derglow/NixieClock/README.md

# NixieClock
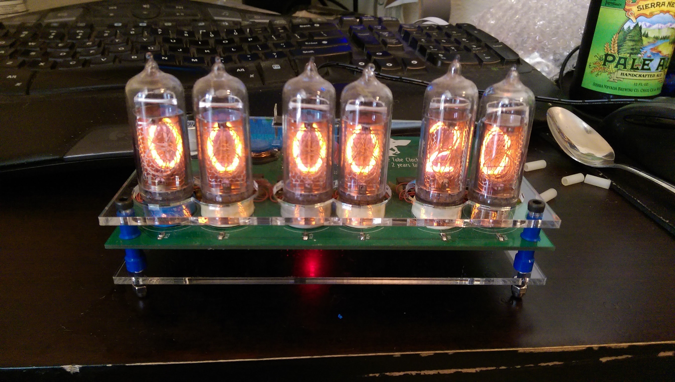
[picture p1: NixieFrontView.jpg]

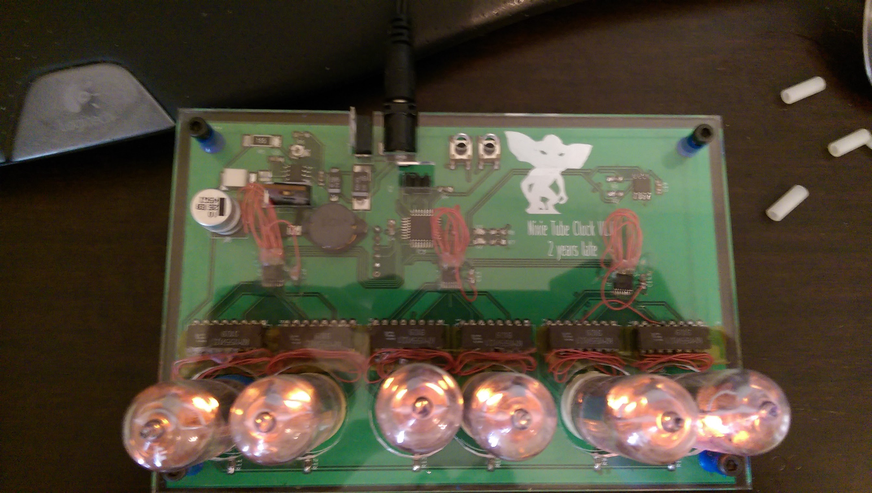
[picture p2: NixieTopView.jpg]

This repository contains the files used to make my nixie clock design. I designed the PCBs, the laser cut acrylic, and wrote the code.
