derglow/NixieClock/KiCADFinalBoard/BOM.xlsx

Sheet: FullBoardBOM
value | ref | value5 | footprint | lib | part | DigiKey PN | Column1
 | C1 | 10uF,25V | Capacitors_Tantalum_SMD:TantalC_SizeC_EIA-6032_HandSoldering | device | CP | 718-1098-1-ND
 | C10 | 100nF | Capacitors_SMD:C_0805_HandSoldering | device | C | 1276-1007-1-ND
 | C11 | 100nF | Capacitors_SMD:C_0805_HandSoldering | device | C | 1276-1007-1-ND
 | C12 | 100nF | Capacitors_SMD:C_0805_HandSoldering | device | C | 1276-1007-1-ND
 | C13 | 100nF | Capacitors_SMD:C_0805_HandSoldering | device | C | 1276-1007-1-ND
 | C14 | 100nF | Capacitors_SMD:C_0805_HandSoldering | device | C | 1276-1007-1-ND
 | C15 | 100nF | Capacitors_SMD:C_0805_HandSoldering | device | C | 1276-1007-1-ND
 | C16 | 100nF | Capacitors_SMD:C_0805_HandSoldering | device | C | 1276-1007-1-ND
 | C17 | 100nF | Capacitors_SMD:C_0805_HandSoldering | device | C | 1276-1007-1-ND
 | C18 | 100nF | Capacitors_SMD:C_0805_HandSoldering | device | C | 1276-1007-1-ND
 | C19 | 100nF | Capacitors_SMD:C_0805_HandSoldering | device | C | 1276-1007-1-ND
 | C2 | 100nF | Capacitors_SMD:C_0805_HandSoldering | device | C | 1276-1007-1-ND
 | C3 | 100nF | Capacitors_SMD:C_0805_HandSoldering | device | C | 1276-1007-1-ND
 | C4 | 100nF | Capacitors_SMD:C_0805_HandSoldering | device | C | 1276-1007-1-ND
 | C6 | 100nF | Capacitors_SMD:C_0805_HandSoldering | device | C | 1276-1007-1-ND
 | C7 | 100uF,35V | Capacitors_Tantalum_SMD:TantalC_SizeE_EIA-7360_HandSoldering | device | CP | 718-1774-1-ND
 | C8 | 4u7,250V | Capacitors_SMD:c_elec_10x10 | device | CP | PCE3432CT-ND
 | C9 | 100nF,250V | Capacitors_SMD:C_2220_HandSoldering | device | C | 399-5481-1-ND
 | D1 | D | Diodes_SMD:Diode-MELF_Handsoldering | device | D | ES2F-E3/52TGICT-ND
 | D2 | LED | LEDs:LED-0805 | device | LED | NA
 | D3 | LED | LEDs:LED-0805 | device | LED | NA
 | IC1 | DS3231M | SMD_Packages:SOIC-8-N | NixieBoardKiCAD | DS3231M | DS3231MZ+-ND
 | IC10 | 74141 | Housings_DIP:DIP-16_W7.62mm_LongPads | NixieBoardKiCAD | 74141 | NA
 | IC11 | 74141 | Housings_DIP:DIP-16_W7.62mm_LongPads | NixieBoardKiCAD | 74141 | NA
 | IC12 | 74141 | Housings_DIP:DIP-16_W7.62mm_LongPads | NixieBoardKiCAD | 74141 | NA
 | IC2 | MAX1771 | SMD_Packages:SOIC-8-N | NixieBoardKiCAD | MAX1771 | MAX1771CSA+-ND
 | IC3 | ATMEGA328-A | NixieProjFootprints:TQFP32_Long | atmel | ATMEGA328-A | ATMEGA328P-AU-ND
 | IC4 | 74141 | Housings_DIP:DIP-16_W7.62mm_LongPads | NixieBoardKiCAD | 74141 | NA
 | IC5 | 74141 | Housings_DIP:DIP-16_W7.62mm_LongPads | NixieBoardKiCAD | 74141 | NA
 | IC6 | SN74AHC594 | Housings_SSOP:TSSOP-16_4.4x5mm_Pitch0.65mm | NixieBoardKiCAD | SN74AHC594 | 296-4620-1-ND
 | IC7 | SN74AHC594 | Housings_SSOP:TSSOP-16_4.4x5mm_Pitch0.65mm | NixieBoardKiCAD | SN74AHC594 | 296-4620-1-ND
 | IC8 | SN74AHC594 | Housings_SSOP:TSSOP-16_4.4x5mm_Pitch0.65mm | NixieBoardKiCAD | SN74AHC594 | 296-4620-1-ND
 | IC9 | 74141 | Housings_DIP:DIP-16_W7.62mm_LongPads | NixieBoardKiCAD | 74141 | NA
 | L1 | 100uH | NixieProjFootprints:Inductor | device | INDUCTOR | M8603CT-ND
 | N1 | Nixie_IN-14 | NixieProjFootprints:Nixie_IN14 | nixieKiCadrev1-cache | Nixie_IN-14 | NA
 | N2 | Nixie_IN-14 | NixieProjFootprints:Nixie_IN14 | nixieKiCadrev1-cache | Nixie_IN-14 | NA
 | N3 | Nixie_IN-14 | NixieProjFootprints:Nixie_IN14 | nixieKiCadrev1-cache | Nixie_IN-14 | NA
 | N4 | Nixie_IN-14 | NixieProjFootprints:Nixie_IN14 | nixieKiCadrev1-cache | Nixie_IN-14 | NA
 | N5 | Nixie_IN-14 | NixieProjFootprints:Nixie_IN14 | nixieKiCadrev1-cache | Nixie_IN-14 | NA
 | N6 | Nixie_IN-14 | NixieProjFootprints:Nixie_IN14 | nixieKiCadrev1-cache | Nixie_IN-14 | NA
 | P1 | CONN_01X02 | Connect:BARREL_JACK | conn | CONN_01X02 | NA
 | P2 | CONN_02X03 | Pin_Headers:Pin_Header_Straight_2x03 | conn | CONN_02X03 | NA
 | P3 | Battery | NixieProjFootprints:CR2032_BatHolder | conn | CONN_01X02 | NA
 | Q1 | Q_NMOS_DGS | TO_SOT_Packages_THT:TO-220_Neutral123_Vertical | device | Q_NMOS_DGS | IRF644PBF-ND
 | R1 | 4k7 | Resistors_SMD:R_0805_HandSoldering | device | R | 311-4.7KARCT-ND
 | R10 | R180k | Resistors_SMD:R_0805_HandSoldering | device | R | 311-180KARCT-ND | 311-100KARCT-ND
 | R11 | R180k | Resistors_SMD:R_0805_HandSoldering | device | R | 311-180KARCT-ND | 311-100KARCT-ND
 | R12 | R180k | Resistors_SMD:R_0805_HandSoldering | device | R | 311-180KARCT-ND | 311-100KARCT-ND
 | R13 | R180k | Resistors_SMD:R_0805_HandSoldering | device | R | 311-180KARCT-ND | 311-100KARCT-ND
 | R14 | R180k | Resistors_SMD:R_0805_HandSoldering | device | R | 311-180KARCT-ND | 311-100KARCT-ND
 | R2 | 4k7 | Resistors_SMD:R_0805_HandSoldering | device | R | 311-4.7KARCT-ND
 | R3 | 0R050 | Resistors_SMD:R_2512_HandSoldering | device | R | 985-1555-1-ND
 | R4 | R10k | Resistors_SMD:R_0805_HandSoldering | device | R | 311-10KARCT-ND
 | R5 | 1M5 | Resistors_SMD:R_2512_HandSoldering | device | R | PT1.5MXCT-ND
 | R6 | 10k | Resistors_SMD:R_0805_HandSoldering | device | R | 311-10KARCT-ND
 | R7 | R250 | Resistors_SMD:R_0805_HandSoldering | device | R | 311-240ARCT-ND
 | R8 | R250 | Resistors_SMD:R_0805_HandSoldering | device | R | 311-240ARCT-ND
 | R9 | R180k | Resistors_SMD:R_0805_HandSoldering | device | R | 311-180KARCT-ND | 311-100KARCT-ND
 | RV1 | POT | NixieProjFootprints:TrimPot | device | POT | P3V502CT-ND
 | SW1 | SW_PUSH | Buttons_Switches_SMD:SW_SPST_PTS645 | device | SW_PUSH | 450-1129-ND
 | SW2 | SW_PUSH | Buttons_Switches_SMD:SW_SPST_PTS645 | device | SW_PUSH | 450-1129-ND
 | U1 | 7805_Nix | TO_SOT_Packages_THT:TO-220_Neutral123_Vertical | NixieBoardKiCAD | 7805_Nix | NA
 | U2 | GPS | NixieProjFootprints:EM406gps | NixieBoardKiCAD | GPS | NA

Sheet: HVPSBOM
My Designator | Original designator | value | package | desc | manu | man p/n | digikey | price | comments
C7 | C1 | 100uF,35V | C-EIA-7343 | Capacitor, Tantalum, EU 7343 case, polarised | AVX | TPSD107M035 | 478-1746-1-ND | 1.31 | Use lowest ESR available
NA | C2,C3 | 100n | C0805 | CAPACITOR, European symbol |  |  | 490-1726-1-ND |  | Any generic 100nF 0805 cap
C8 | C4 | 10u7,250V | PANASONIC-ECG | Capacitor, Electrolytic, polarised | Panasonic | EEV-EB2E100Q | PCE3432CT-ND | 0.68 | Low ESR < 3ohms
C1 | C5 | 10uF,25V | C-EIA-7343 | Capacitor, Tantalum, EU 7343 case, polarised | AVX | TPSW106M025 | P11295CT-ND | 0.62 | Use lowest ESR available
C9 | C6 | 100n,250V | C2420 |  | Panasonic | ECWU2104KC9 | PCF1412CT-ND | 1.13 | Optional
 | D1 | ES2F | SMB | DIODE | ST | ES2F | ES2F-E3/52TGITR-ND | 0.74 | Must have very fast mttr
 | IC1 | MAX1771ESA | SO-8 |  | Maxim | MAX1771ESA | MAX1771ESA-ND |  | Get from Maxim as a sample etc.
 | L1 | 100uH | L-B82479 | SMT power inductors | Epcos | B82479-A1-104M | 436-1111-1-ND | 3.31 | 2A or close
 | R1 | 10K | R0805 | RESISTOR, European symbol |  |  | 311-10.0KCCT-ND |  | Use any generic 10Kohm 0805 resistor
 | R2 | 1M5 | R2512 | RESISTOR, European symbol | Phicomp | PRC221 series | PT1.5MXCT-ND | 0.16 | 1 watt, 5%
 | RSENSE | 0R050 | R2010 | RESISTOR, European symbol | Welwyn | LR2010-R05FW | P50MCT-ND | 0.66 | 2A current rating - 1Watt in a 2010 case
 | T1 | IRF644PBF | TO220BV | N-CHANNEL MOS FET | Vishay | IRF644PBF | IRF644PBF-ND | 2.12 | IRF740A will do (only "A" or "B" versions)
 | VR1 | 5K | BOURNS-3214W |  | Bourns | 3214W-1-502E | 3214W-502ECT-ND | 1.58 | Multi-turn - Any similar will do
