derglow/NixieClock/Laser Cut Files/top.dxf

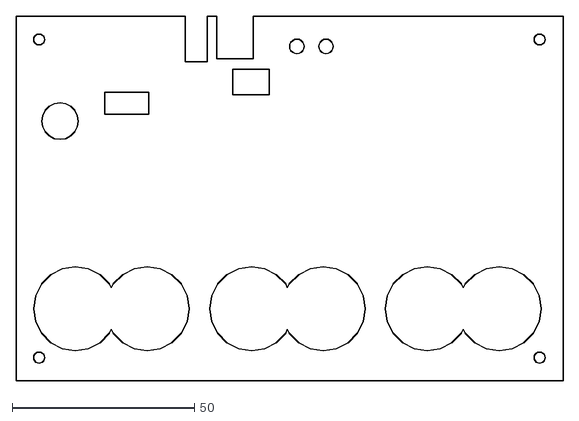
[picture p3: CAD file, 2018-04-29]
Laser Cut Files/top.dxf
150.0 x 100.0
