derglow/NixieClock/Laser Cut Files/NixieAcrylic.dxf

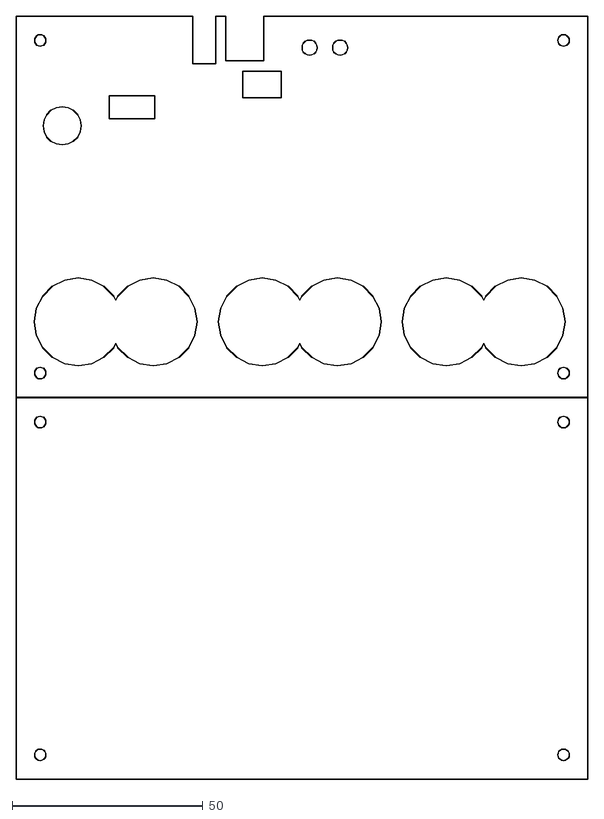
[picture p4: CAD file, 2018-04-29]
Laser Cut Files/NixieAcrylic.dxf
150.0 x 200.1
