derglow/NixieClock/Laser Cut Files/bottom.dxf

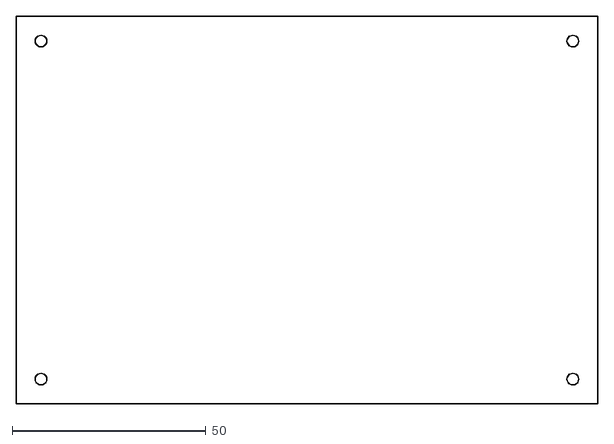
[picture p5: CAD file, 2018-04-29]
Laser Cut Files/bottom.dxf
150.0 x 100.0
