derglow/NixieClock/(list of files, cad)

Other CAD files:
Laser Cut Files/top.scad
