derglow/NixieClock/KiCADFinalBoard/nixieKiCadrev1.kicad_pcb

## KiCad design KiCADFinalBoard/nixieKiCadrev1.kicad_pcb (2018-04-29)

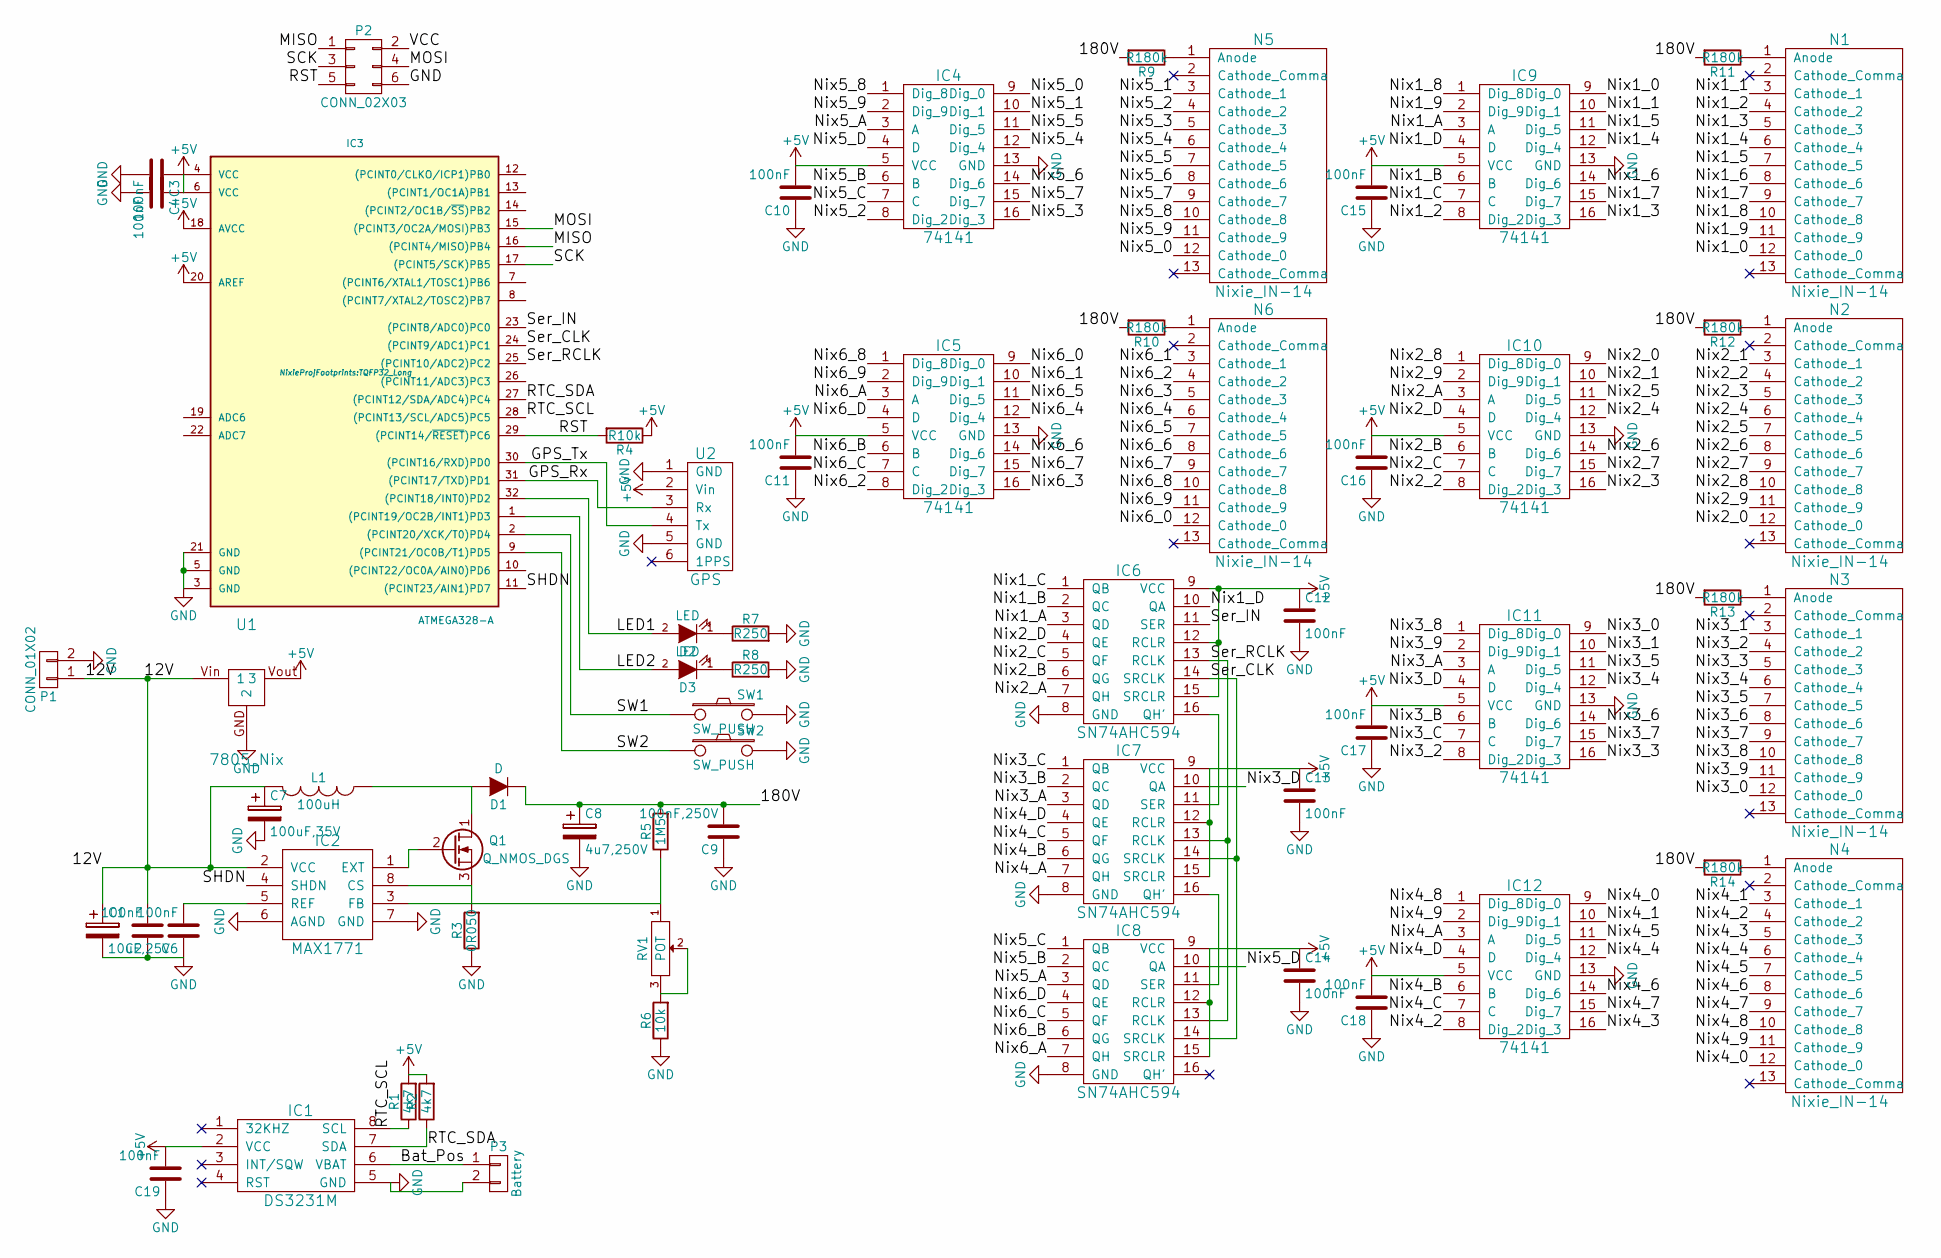
[picture p6: schematic nixieKiCadrev1.sch]

Parts:
C1: 10uF,25V; TantalC_SizeC_EIA-6032_HandSoldering
C2, C3, C4, C6, C10, C11, C12, C13, C14, C15, C16, C17, C18, C19: 100nF; C_0805_HandSoldering
C7: 100uF,35V; TantalC_SizeE_EIA-7360_HandSoldering
C8: 4u7,250V; c_elec_10x10
C9: 100nF,250V; C_2220_HandSoldering
D1: D; Diode-MELF_Handsoldering
D2, D3: LED; LED-0805
IC1: DS3231M; SOIC-8-N
IC2: MAX1771; SOIC-8-N
IC3: ATMEGA328-A; TQFP32_Long
IC4, IC5, IC9, IC10, IC11, IC12: 74141; DIP-16_W7.62mm_LongPads
IC6, IC7, IC8: SN74AHC594; TSSOP-16_4.4x5mm_Pitch0.65mm
L1: 100uH; Inductor
N1, N2, N3, N4, N5, N6: Nixie_IN-14; Nixie_IN14
P1: CONN_01X02; BARREL_JACK
P2: CONN_02X03; Pin_Header_Straight_2x03
P3: Battery; CR2032_BatHolder
Q1: Q_NMOS_DGS; TO-220_Neutral123_Vertical
R1, R2: 4k7; R_0805_HandSoldering
R3: 0R050; R_2512_HandSoldering
R4: R10k; R_0805_HandSoldering
R5: 1M5; R_2512_HandSoldering
R6: 10k; R_0805_HandSoldering
R7, R8: R250; R_0805_HandSoldering
R9, R10, R11, R12, R13, R14: R180k; R_0805_HandSoldering
RV1: POT; TrimPot
SW1, SW2: SW_PUSH; SW_SPST_PTS645
U1: 7805_Nix; TO-220_Neutral123_Vertical
U2: GPS; EM406gps

Connections:
+5V: C3.1, C4.1, C10.2, C11.2, C12.1, C13.1, C14.1, C15.2, C16.2, C17.2, C18.2, C19.2, IC1.2 (VCC), IC3.4 (VCC), IC3.6 (VCC), IC3.18 (AVCC), IC3.20 (AREF), IC4.5 (VCC), IC5.5 (VCC), IC6.9 (VCC), IC6.12 (RCLR), IC6.15 (SRCLR), IC7.9 (VCC), IC7.12 (RCLR), IC7.15 (SRCLR), IC8.9 (VCC), IC8.12 (RCLR), IC8.15 (SRCLR), IC9.5 (VCC), IC10.5 (VCC), IC11.5 (VCC), IC12.5 (VCC), R1.2, R2.2, R4.1, U1.3, U1.Vout (3), U2.2 (Vin)
/12V: C1.1, C2.2, C7.1, IC2.2 (VCC), L1.2, P1.1, U1.1, U1.Vin (1)
/180V: C8.1, C9.2, D1.1 (K), R5.2, R9.2, R10.2, R11.2, R12.2, R13.2, R14.2
/Bat_Pos: IC1.6 (VBAT), P3.1
/GPS_Rx: IC3.31 ((PCINT17/TXD)PD1), U2.3 (Rx)
/GPS_Tx: IC3.30 ((PCINT16/RXD)PD0), U2.4 (Tx)
/LED1: D2.2 (A), IC3.32 ((PCINT18/INT0)PD2)
/LED2: D3.2 (A), IC3.1 ((PCINT19/OC2B/INT1)PD3)
/MISO: IC3.16 ((PCINT4/MISO)PB4), P2.1
/MOSI: IC3.15 ((PCINT3/OC2A/MOSI)PB3), P2.4
/Nix1_0: IC9.9 (Dig_0), N1.12 (Cathode_0)
/Nix1_1: IC9.10 (Dig_1), N1.3 (Cathode_1)
/Nix1_2: IC9.8 (Dig_2), N1.4 (Cathode_2)
/Nix1_3: IC9.16 (Dig_3), N1.5 (Cathode_3)
/Nix1_4: IC9.12 (Dig_4), N1.6 (Cathode_4)
/Nix1_5: IC9.11 (Dig_5), N1.7 (Cathode_5)
/Nix1_6: IC9.14 (Dig_6), N1.8 (Cathode_6)
/Nix1_7: IC9.15 (Dig_7), N1.9 (Cathode_7)
/Nix1_8: IC9.1 (Dig_8), N1.10 (Cathode_8)
/Nix1_9: IC9.2 (Dig_9), N1.11 (Cathode_9)
/Nix1_A: IC6.3 (QD), IC9.3 (A)
/Nix1_B: IC6.2 (QC), IC9.6 (B)
/Nix1_C: IC6.1 (QB), IC9.7 (C)
/Nix1_D: IC6.10 (QA), IC9.4 (D)
/Nix2_0: IC10.9 (Dig_0), N2.12 (Cathode_0)
/Nix2_1: IC10.10 (Dig_1), N2.3 (Cathode_1)
/Nix2_2: IC10.8 (Dig_2), N2.4 (Cathode_2)
/Nix2_3: IC10.16 (Dig_3), N2.5 (Cathode_3)
/Nix2_4: IC10.12 (Dig_4), N2.6 (Cathode_4)
/Nix2_5: IC10.11 (Dig_5), N2.7 (Cathode_5)
/Nix2_6: IC10.14 (Dig_6), N2.8 (Cathode_6)
/Nix2_7: IC10.15 (Dig_7), N2.9 (Cathode_7)
/Nix2_8: IC10.1 (Dig_8), N2.10 (Cathode_8)
/Nix2_9: IC10.2 (Dig_9), N2.11 (Cathode_9)
/Nix2_A: IC6.7 (QH), IC10.3 (A)
/Nix2_B: IC6.6 (QG), IC10.6 (B)
/Nix2_C: IC6.5 (QF), IC10.7 (C)
/Nix2_D: IC6.4 (QE), IC10.4 (D)
/Nix3_0: IC11.9 (Dig_0), N3.12 (Cathode_0)
/Nix3_1: IC11.10 (Dig_1), N3.3 (Cathode_1)
/Nix3_2: IC11.8 (Dig_2), N3.4 (Cathode_2)
/Nix3_3: IC11.16 (Dig_3), N3.5 (Cathode_3)
/Nix3_4: IC11.12 (Dig_4), N3.6 (Cathode_4)
/Nix3_5: IC11.11 (Dig_5), N3.7 (Cathode_5)
/Nix3_6: IC11.14 (Dig_6), N3.8 (Cathode_6)
/Nix3_7: IC11.15 (Dig_7), N3.9 (Cathode_7)
/Nix3_8: IC11.1 (Dig_8), N3.10 (Cathode_8)
/Nix3_9: IC11.2 (Dig_9), N3.11 (Cathode_9)
/Nix3_A: IC7.3 (QD), IC11.3 (A)
/Nix3_B: IC7.2 (QC), IC11.6 (B)
/Nix3_C: IC7.1 (QB), IC11.7 (C)
/Nix3_D: IC7.10 (QA), IC11.4 (D)
/Nix4_0: IC12.9 (Dig_0), N4.12 (Cathode_0)
/Nix4_1: IC12.10 (Dig_1), N4.3 (Cathode_1)
/Nix4_2: IC12.8 (Dig_2), N4.4 (Cathode_2)
/Nix4_3: IC12.16 (Dig_3), N4.5 (Cathode_3)
/Nix4_4: IC12.12 (Dig_4), N4.6 (Cathode_4)
/Nix4_5: IC12.11 (Dig_5), N4.7 (Cathode_5)
/Nix4_6: IC12.14 (Dig_6), N4.8 (Cathode_6)
/Nix4_7: IC12.15 (Dig_7), N4.9 (Cathode_7)
/Nix4_8: IC12.1 (Dig_8), N4.10 (Cathode_8)
/Nix4_9: IC12.2 (Dig_9), N4.11 (Cathode_9)
/Nix4_A: IC7.7 (QH), IC12.3 (A)
/Nix4_B: IC7.6 (QG), IC12.6 (B)
/Nix4_C: IC7.5 (QF), IC12.7 (C)
/Nix4_D: IC7.4 (QE), IC12.4 (D)
/Nix5_0: IC4.9 (Dig_0), N5.12 (Cathode_0)
/Nix5_1: IC4.10 (Dig_1), N5.3 (Cathode_1)
/Nix5_2: IC4.8 (Dig_2), N5.4 (Cathode_2)
/Nix5_3: IC4.16 (Dig_3), N5.5 (Cathode_3)
/Nix5_4: IC4.12 (Dig_4), N5.6 (Cathode_4)
/Nix5_5: IC4.11 (Dig_5), N5.7 (Cathode_5)
/Nix5_6: IC4.14 (Dig_6), N5.8 (Cathode_6)
/Nix5_7: IC4.15 (Dig_7), N5.9 (Cathode_7)
/Nix5_8: IC4.1 (Dig_8), N5.10 (Cathode_8)
/Nix5_9: IC4.2 (Dig_9), N5.11 (Cathode_9)
/Nix5_A: IC4.3 (A), IC8.3 (QD)
/Nix5_B: IC4.6 (B), IC8.2 (QC)
/Nix5_C: IC4.7 (C), IC8.1 (QB)
/Nix5_D: IC4.4 (D), IC8.10 (QA)
/Nix6_0: IC5.9 (Dig_0), N6.12 (Cathode_0)
/Nix6_1: IC5.10 (Dig_1), N6.3 (Cathode_1)
/Nix6_2: IC5.8 (Dig_2), N6.4 (Cathode_2)
/Nix6_3: IC5.16 (Dig_3), N6.5 (Cathode_3)
/Nix6_4: IC5.12 (Dig_4), N6.6 (Cathode_4)
/Nix6_5: IC5.11 (Dig_5), N6.7 (Cathode_5)
/Nix6_6: IC5.14 (Dig_6), N6.8 (Cathode_6)
/Nix6_7: IC5.15 (Dig_7), N6.9 (Cathode_7)
/Nix6_8: IC5.1 (Dig_8), N6.10 (Cathode_8)
/Nix6_9: IC5.2 (Dig_9), N6.11 (Cathode_9)
/Nix6_A: IC5.3 (A), IC8.7 (QH)
/Nix6_B: IC5.6 (B), IC8.6 (QG)
/Nix6_C: IC5.7 (C), IC8.5 (QF)
/Nix6_D: IC5.4 (D), IC8.4 (QE)
/RST: IC3.29 ((PCINT14/~RESET~)PC6), P2.5, R4.2
/RTC_SCL: IC1.8 (SCL), IC3.28 ((PCINT13/SCL/ADC5)PC5), R1.1
/RTC_SDA: IC1.7 (SDA), IC3.27 ((PCINT12/SDA/ADC4)PC4), R2.1
/SCK: IC3.17 ((PCINT5/SCK)PB5), P2.3
/SHDN: IC2.4 (SHDN), IC3.11 ((PCINT23/AIN1)PD7)
/SW1: IC3.2 ((PCINT20/XCK/T0)PD4), SW1.1
/SW2: IC3.9 ((PCINT21/OC0B/T1)PD5), SW2.1
/Ser_CLK: IC3.24 ((PCINT9/ADC1)PC1), IC6.14 (SRCLK), IC7.14 (SRCLK), IC8.14 (SRCLK)
/Ser_IN: IC3.23 ((PCINT8/ADC0)PC0), IC6.11 (SER)
/Ser_RCLK: IC3.25 ((PCINT10/ADC2)PC2), IC6.13 (RCLK), IC7.13 (RCLK), IC8.13 (RCLK)
/VCC: P2.2
GND: C1.2, C2.1, C3.2, C4.2, C6.1, C7.2, C8.2, C9.1, C10.1, C11.1, C12.2, C13.2, C14.2, C15.1, C16.1, C17.1, C18.1, C19.1, IC1.5 (GND), IC2.6 (AGND), IC2.7 (GND), IC3.3 (GND), IC3.5 (GND), IC3.21 (GND), IC4.13 (GND), IC5.13 (GND), IC6.8 (GND), IC7.8 (GND), IC8.8 (GND), IC9.13 (GND), IC10.13 (GND), IC11.13 (GND), IC12.13 (GND), P1.2, P2.6, P3.2, R3.1, R6.1, R7.2, R8.2, SW1.2, SW2.2, U1.2, U1.GND (2), U2.1 (GND), U2.5 (GND)
unnamed: C6.2, IC2.5 (REF)
unnamed: D1.2 (A), L1.1, Q1.1 (D)
unnamed: D2.1 (K), R7.1
unnamed: D3.1 (K), R8.1
unnamed: IC2.1 (EXT), Q1.2 (G)
unnamed: IC2.3 (FB), R5.1, RV1.1
unnamed: IC2.8 (CS), Q1.3 (S), R3.2
unnamed: IC6.16 (QH'), IC7.11 (SER)
unnamed: IC7.16 (QH'), IC8.11 (SER)
unnamed: N1.1 (Anode), R11.1
unnamed: N2.1 (Anode), R12.1
unnamed: N3.1 (Anode), R13.1
unnamed: N4.1 (Anode), R14.1
unnamed: N5.1 (Anode), R9.1
unnamed: N6.1 (Anode), R10.1
unnamed: R6.2, RV1.2, RV1.3

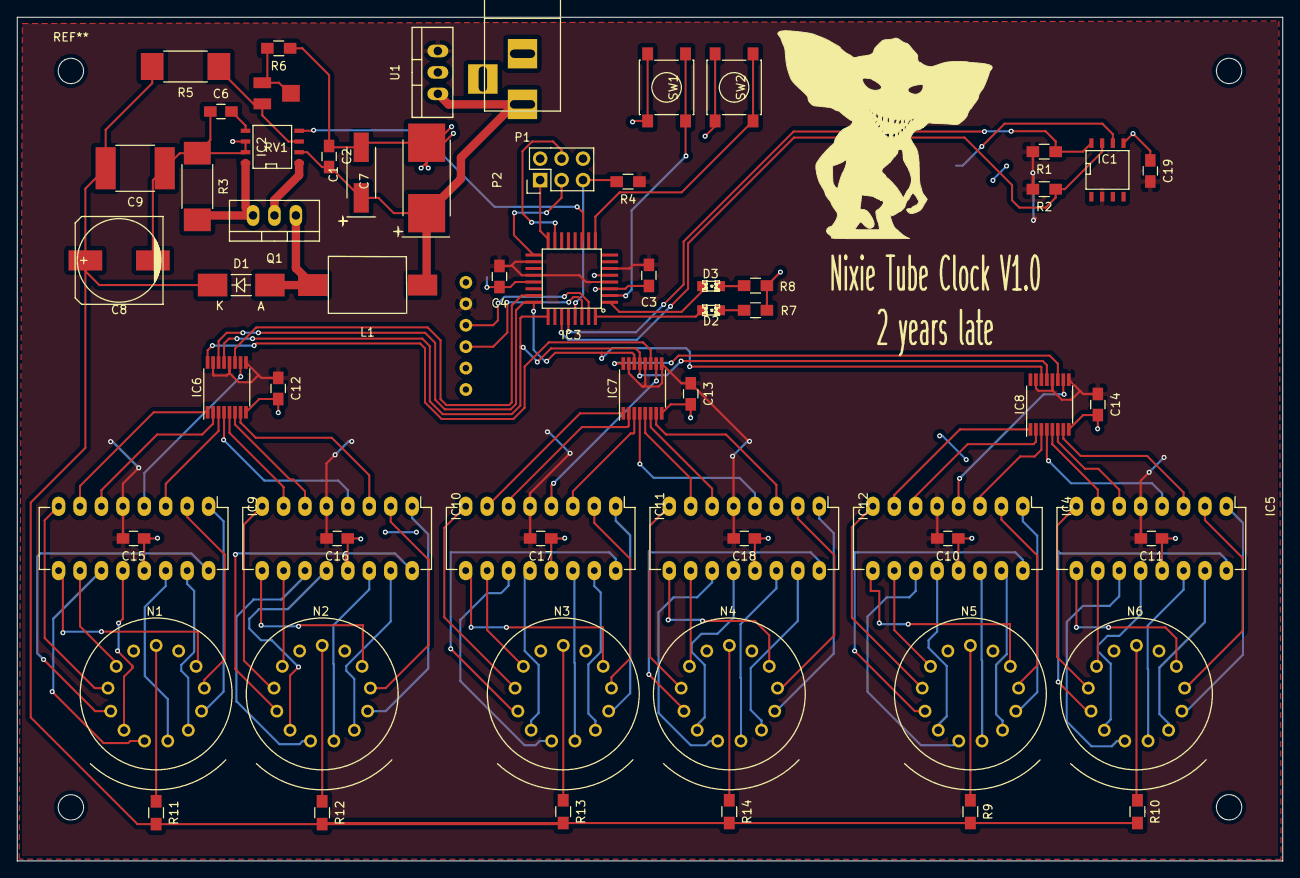
[picture p7: board nixieKiCadrev1.kicad_pcb from above]

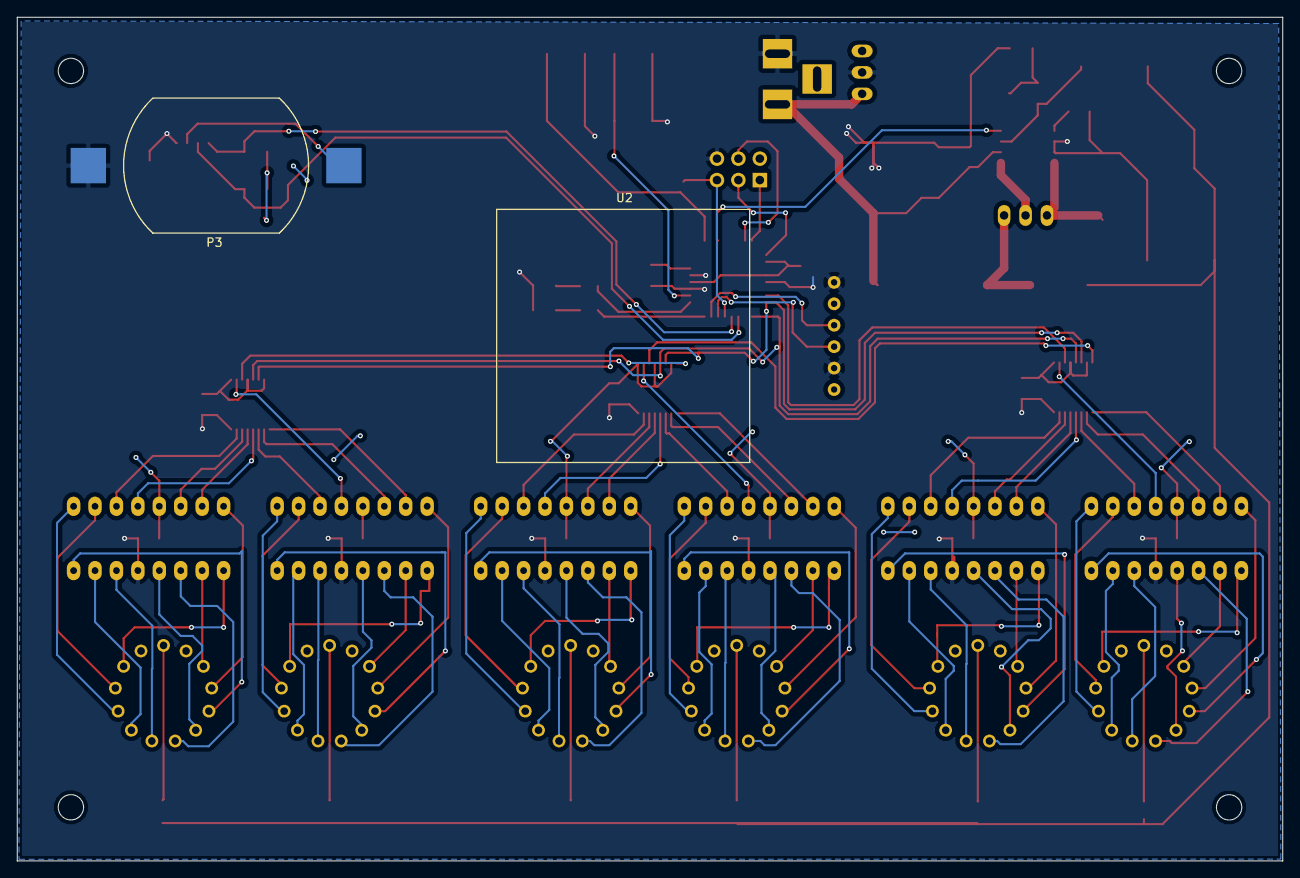
[picture p8: board nixieKiCadrev1.kicad_pcb from below]

Board: 2 copper layers, 150.0 x 100.0 mm, 63 parts (2 on the bottom side), 121 nets.
